diespinoza/room_light_mkr1010/(list of files, drawings)

Other design files:
docs/fritzing/room_light_bench.fzz
docs/fritzing/room_light_final.fzz
