diespinoza/room_light_mkr1010/(commit log)

2026-10-25 Phase 1 bench test: LedStrip driver, serial commands, plan and README
    Arduino MKR WiFi 1010 driving an Adafruit 4689 NeoPixel RGBW neon strip.
    LedStrip wraps Adafruit_NeoPixel with 16-bit gamma, master brightness,
    a current limiter and non-blocking fades. The sketch takes colour
    commands over USB serial and includes a pintest for multimeter checks.
2026-10-25 Add bench wiring diagram (SVG)
2026-10-25 Wiring diagram: untangle labels around the screw terminal
2026-10-25 Add generated Fritzing sketch of the bench wiring
    [room_light_bench.fzz]
2026-10-25 Limiter: scale in 16-bit before quantising to stop clamped-fade jitter
    With the cap engaged during a fade, per-frame integer rounding of the
    scale factor made 8-bit outputs jitter by one count, visible as shimmer
    on the all-channels test steps.
    [LedStrip.cpp, LedStrip.h]
2026-10-25 Add refresh command; replace generated Fritzing sketch with hand-tidied layout
    [room_light_bench.fzz]
2026-10-25 Bench cap 350 mA; document the low-rail shimmer measurement
2026-10-26 README: record where the 1.4 V of drop goes on the bench
2026-10-26 Perfboard build guide and hole-exact layout drawing for the 74AHCT125 build
2026-10-26 Fritzing sketch for the final 74AHCT125 build; keep the generator in the repo
    [room_light_final.fzz]
2026-10-26 Phase 2: WiFi connection, LightState model, HTTP JSON API and phone web page
    - Network: WiFiNINA connect with non-blocking retry, hostname, status
    - LightState: on/off, colour, brightness, presets; single model that the
    serial shell and the web API both drive
    - WebUI: minimal HTTP server, GET/POST /api/state, GET /api/presets,
    page served from flash
    - index_html: phone page with switch, brightness, colour picker, white
    slider and preset buttons; polls state every 5 s
    - secrets.example.h; secrets.h stays git-ignored
    [room_light_final.fzz]
2026-10-26 Phase 3: effects, state saved to flash, roomlight.local via mDNS
    - Effects: breathe, cycle, rainbow, candle, twinkle with a speed control,
    rendered from LightState each frame
    - Persist: SavedState in SAMD flash via FlashStorage, debounced 3 s after
    the last change, restored before the first frame at boot
    - Network: ArduinoMDNS advertises roomlight.local and an _http service,
    restarted on every reconnect; USE_MDNS=0 to build without the library
    - API: effect/speed in state, GET /api/effects; page gets an effects card
    and speed slider; serial gets effect, speed, save
2026-10-26 Status LED on the NINA module; draw saved effects before the WiFi connect
    The first loop iteration blocked in WiFi.begin() before a saved effect had
    rendered a frame, so the strip showed the default soft white until WiFi was
    up. Effects now render once in setup and the loop renders before the
    network step. The WiFi module's RGB LED shows connecting / connected /
    lost; the board's own LED shares pin 6 with the strip data.
2026-10-26 Non-blocking WiFi state machine, NINA module reset, hardware watchdog
    - Network: send the connect request and poll status from loop() instead of
    WiFi.begin()'s 10 s blocking wait, so effects and the status LED keep
    running; distinct idle/connecting/connected/failed states with counters
    - Reset the NINA through its reset pin after 3 consecutive failed attempts
    (the 200-attempt never-reconnects case); wifireset command
    - Watchdog: SAMD21 WDT at ~16 s fed from loop() and from WiFiNINA's own
    feed hook, so a wedged SPI link reboots the board into the saved state;
    boot banner prints the reset cause; reboot command
    - README: reliability section and arduino-fwuploader instructions
    Co-Auth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
    [Network.cpp, Network.h, Watchdog.cpp, Watchdog.h, config.h, room_light_mkr1010.ino]
